JACart/jacart_electronics/PCBFiles/JACart - Rev 3/JACartCommBoard.kicad_pcb

## KiCad design PCBFiles/JACart - Rev 3/JACartCommBoard.kicad_pcb (2022-08-04)

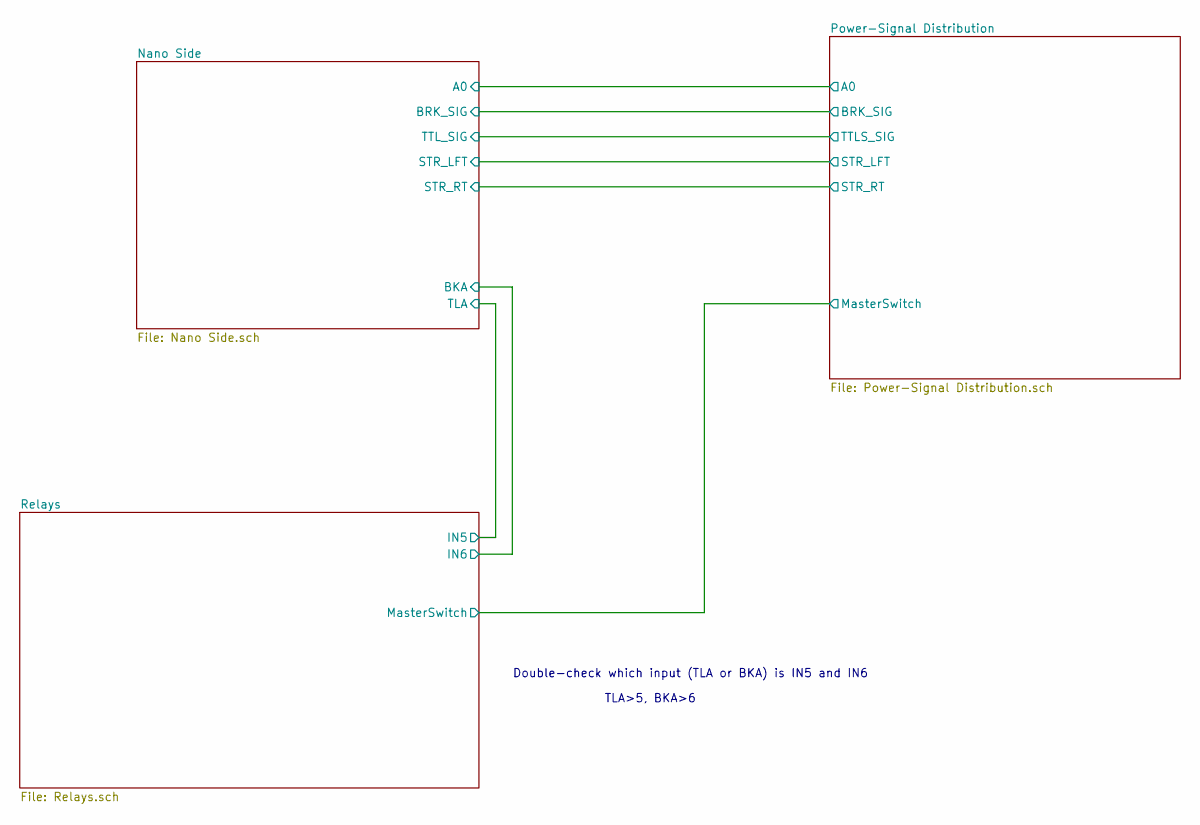
[picture p2: schematic JACartCommBoard.sch]

Notes on the sheet:
Double-check which input (TLA or BKA) is IN5 and IN6
TLA>5, BKA>6

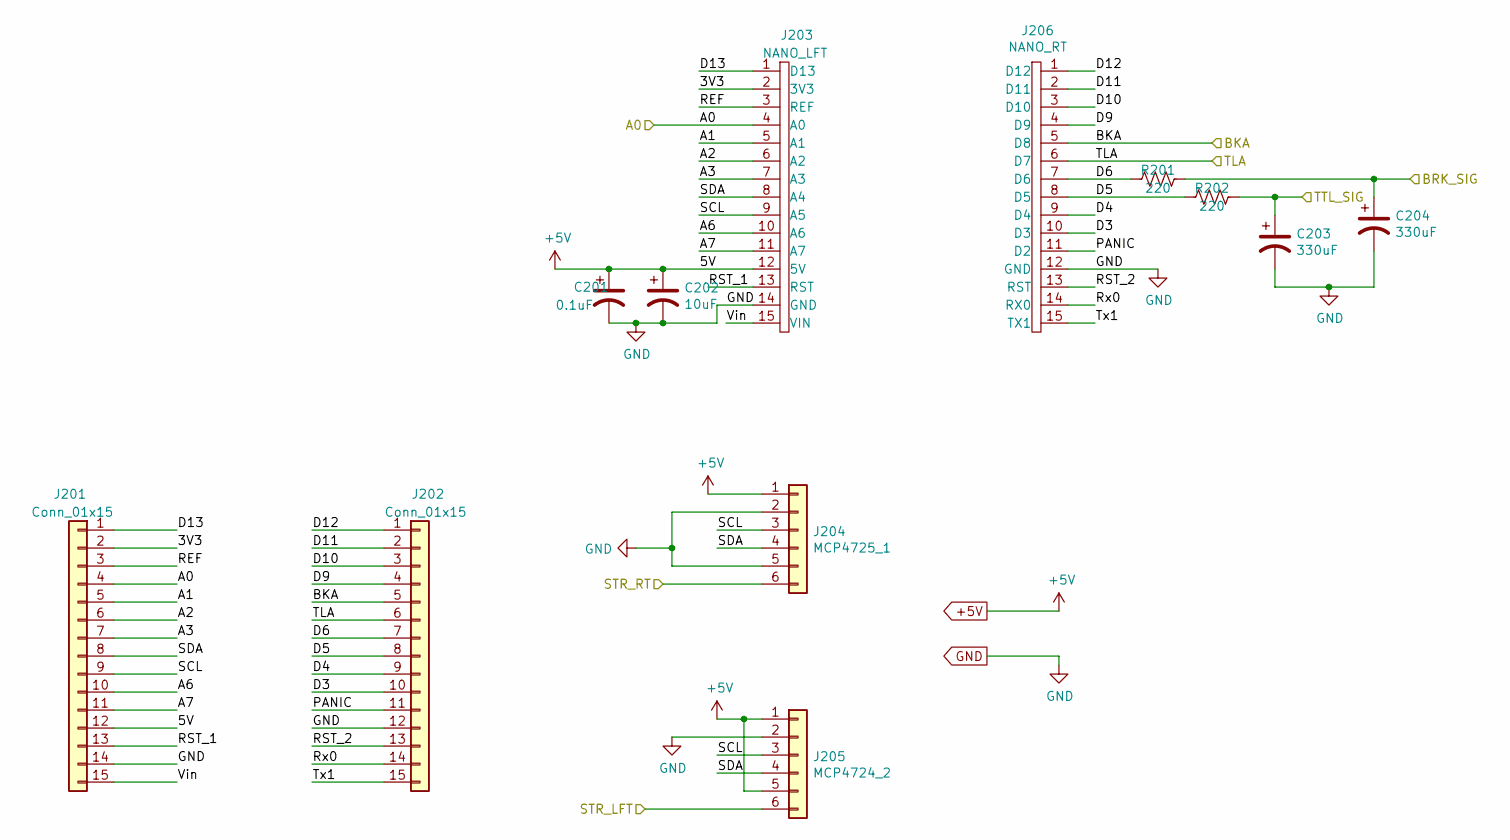
[picture p3: schematic Nano Side.sch]

Parts:
C201: 0.1uF; C_Rect_L7.2mm_W2.5mm_P5.00mm_FKS2_FKP2_MKS2_MKP2
C202: 10uF; CP_Radial_D5.0mm_P2.00mm
C203, C204: 330uF; CP_Radial_D10.0mm_P5.00mm
J201, J202: Conn_01x15; PinHeader_1x15_P2.54mm_Vertical
J203: NANO_LFT; PinSocket_1x15_P2.54mm_Vertical
J204: MCP4725_1; PinSocket_1x06_P2.54mm_Vertical
J205: MCP4724_2; PinSocket_1x06_P2.54mm_Vertical
J206: NANO_RT; PinSocket_1x15_P2.54mm_Vertical
R201, R202: 220; R_1206_3216Metric_Pad1.30x1.75mm_HandSolder

Connections:
+5V: C201.1, C202.1, J201.12 (5V), J203.12 (5V), J204.1, J205.1, J205.5; also elsewhere on the board
/Nano Side/3V3: J201.2 (3V3), J203.2 (3V3)
/Nano Side/A0: J201.4 (A0), J203.4 (A0); also elsewhere on the board
/Nano Side/A1: J201.5 (A1), J203.5 (A1)
/Nano Side/A2: J201.6 (A2), J203.6 (A2)
/Nano Side/A3: J201.7 (A3), J203.7 (A3)
/Nano Side/A6: J201.10 (A6), J203.10 (A6)
/Nano Side/A7: J201.11 (A7), J203.11 (A7)
/Nano Side/BKA: J202.5 (A1), J206.5 (D8); also elsewhere on the board
/Nano Side/D3: J202.10 (A6), J206.10 (D3)
/Nano Side/D4: J202.9 (A5), J206.9 (D4)
/Nano Side/D5: J202.8 (A4), J206.8 (D5), R202.2
/Nano Side/D6: J202.7 (A3), J206.7 (D6), R201.2
/Nano Side/D9: J202.4 (A0), J206.4 (D9)
/Nano Side/D10: J202.3 (REF), J206.3 (D10)
/Nano Side/D11: J202.2 (3V3), J206.2 (D11)
/Nano Side/D12: J202.1 (D13), J206.1 (D12)
/Nano Side/D13: J201.1 (D13), J203.1 (D13)
/Nano Side/PANIC: J202.11 (A7), J206.11 (D2)
/Nano Side/REF: J201.3 (REF), J203.3 (REF)
/Nano Side/RST_1: J201.13 (RST), J203.13 (RST)
/Nano Side/RST_2: J202.13 (RST), J206.13 (RST)
/Nano Side/Rx0: J202.14 (GND), J206.14 (RX0)
/Nano Side/SCL: J201.9 (A5), J203.9 (A5), J204.3, J205.3
/Nano Side/SDA: J201.8 (A4), J203.8 (A4), J204.4, J205.4
/Nano Side/STR_LFT: J205.6; also elsewhere on the board
/Nano Side/STR_RT: J204.6; also elsewhere on the board
/Nano Side/Tx1: J202.15 (VIN), J206.15 (TX1)
/Nano Side/Vin: J201.15 (VIN), J203.15 (VIN)
/Relays/IN5: J202.6 (A2), J206.6 (D7); also elsewhere on the board
GND: C201.2, C202.2, C203.2, C204.2, J201.14 (GND), J202.12 (5V), J203.14 (GND), J204.2, J204.5, J205.2, J206.12 (GND); also elsewhere on the board
NO1: C204.1, R201.1; also elsewhere on the board
NO3: C203.1, R202.1; also elsewhere on the board

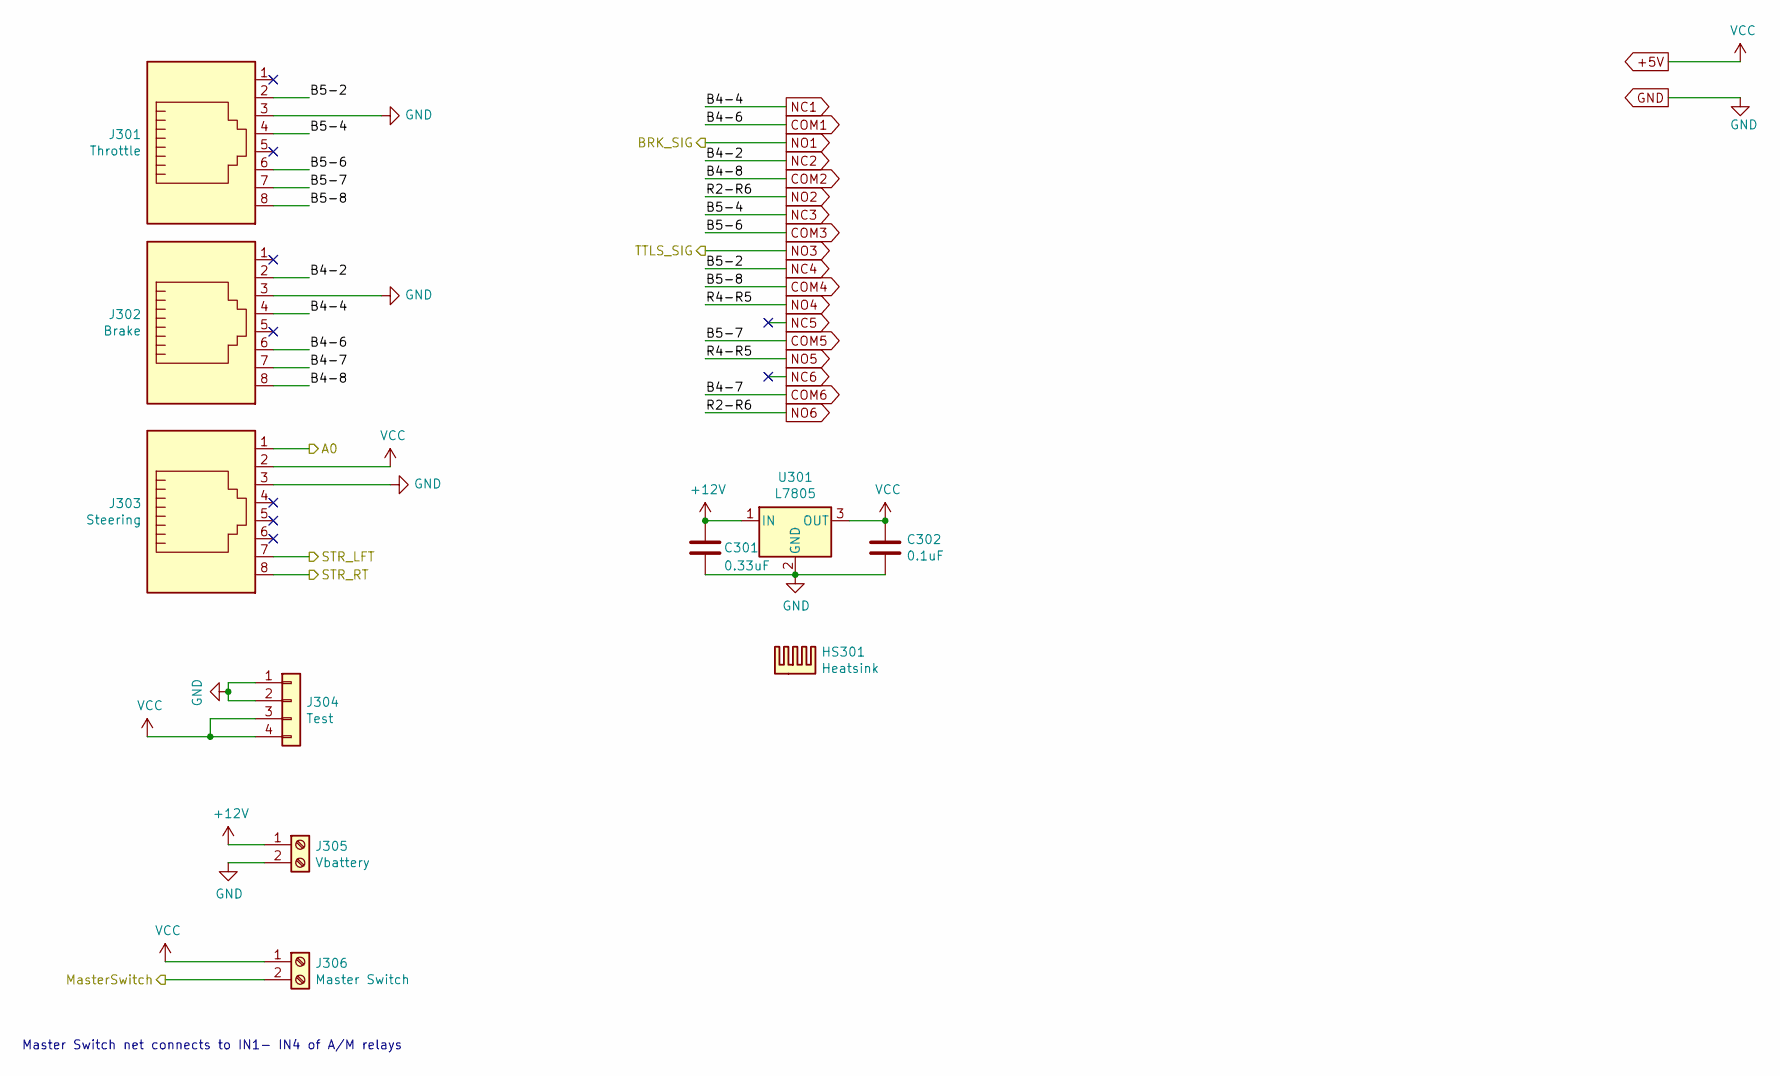
[picture p4: schematic Power-Signal Distribution.sch]

Parts:
C301: 0.33uF; C_1206_3216Metric_Pad1.33x1.80mm_HandSolder
C302: 0.1uF; C_1206_3216Metric_Pad1.33x1.80mm_HandSolder
HS301: Heatsink; HSINK_6398BG
J301: Throttle; TE_1-406525-1
J302: Brake; TE_1-406525-1
J303: Steering; TE_1-406525-1
J304: Test; PinHeader_1x04_P2.54mm_Vertical
J305: Vbattery; TE_282837-2
J306: Master Switch; TE_282837-2
U301: L7805; TO-220-3_Vertical

Connections:
+5V: C302.1, J303.2, J304.3, J304.4, J306.1, U301.3 (OUT); also elsewhere on the board
+12V: C301.1, J305.1, U301.1 (IN)
/Nano Side/A0: J303.1; also elsewhere on the board
/Nano Side/STR_LFT: J303.7; also elsewhere on the board
/Nano Side/STR_RT: J303.8; also elsewhere on the board
/Power-Signal Distribution/MasterSwitch: J306.2; also elsewhere on the board
COM1: J302.6; also elsewhere on the board
COM2: J302.8; also elsewhere on the board
COM3: J301.6; also elsewhere on the board
COM4: J301.8; also elsewhere on the board
COM5: J301.7; also elsewhere on the board
COM6: J302.7; also elsewhere on the board
GND: C301.2, C302.2, J301.3, J302.3, J303.3, J304.1, J304.2, J305.2, U301.2 (GND); also elsewhere on the board
NC1: J302.4; also elsewhere on the board
NC2: J302.2; also elsewhere on the board
NC3: J301.4; also elsewhere on the board
NC4: J301.2; also elsewhere on the board

Notes on the sheet:
Master Switch net connects to IN1- IN4 of A/M relays

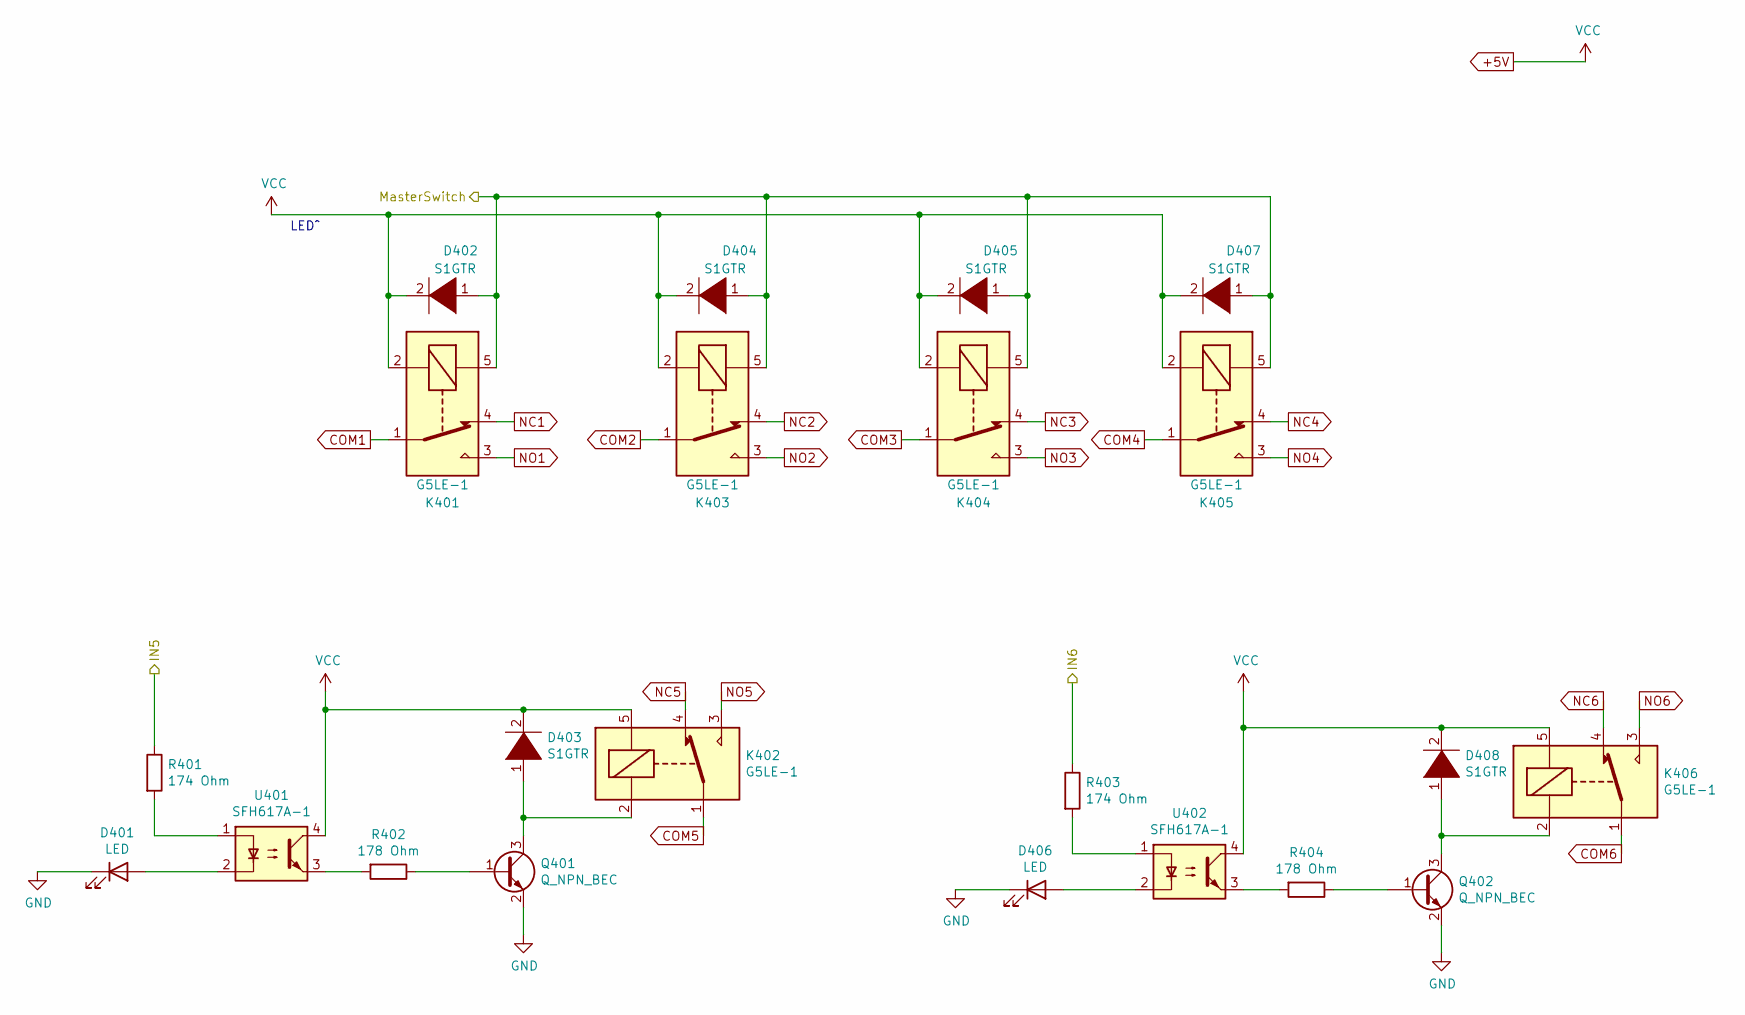
[picture p5: schematic Relays.sch]

Parts:
D401, D406: LED; D_1206_3216Metric_Pad1.42x1.75mm_HandSolder
D402, D403, D404, D405, D407, D408: S1GTR
K401, K402, K403, K404, K405, K406: G5LE-1; Relay_SPDT_Omron-G5LE-1
Q401, Q402: Q_NPN_BEC; TO-126-3_Vertical
R401, R403: 174 Ohm; R_1206_3216Metric_Pad1.30x1.75mm_HandSolder
R402, R404: 178 Ohm; R_1206_3216Metric_Pad1.30x1.75mm_HandSolder
U401, U402: SFH617A-1; DIP-4_W7.62mm

Connections:
+5V: D402.2 (A), D403.2 (A), D404.2 (A), D405.2 (A), D407.2 (A), D408.2 (A), K401.2, K402.5, K403.2, K404.2, K405.2, K406.5, U401.4, U402.4; also elsewhere on the board
/Nano Side/BKA: R403.1; also elsewhere on the board
/Power-Signal Distribution/MasterSwitch: D402.1 (K), D404.1 (K), D405.1 (K), D407.1 (K), K401.5, K403.5, K404.5, K405.5; also elsewhere on the board
/Relays/IN5: R401.1; also elsewhere on the board
COM1: K401.1; also elsewhere on the board
COM2: K403.1; also elsewhere on the board
COM3: K404.1; also elsewhere on the board
COM4: K405.1; also elsewhere on the board
COM5: K402.1; also elsewhere on the board
COM6: K406.1; also elsewhere on the board
GND: D401.1 (K), D406.1 (K), Q401.2 (E), Q402.2 (E); also elsewhere on the board
NC1: K401.4; also elsewhere on the board
NC2: K403.4; also elsewhere on the board
NC3: K404.4; also elsewhere on the board
NC4: K405.4; also elsewhere on the board
NC5: K402.4
NC6: K406.4
NO1: K401.3; also elsewhere on the board
NO3: K404.3; also elsewhere on the board
unnamed: D401.2 (A), U401.2
unnamed: D403.1 (K), K402.2, Q401.3 (C)
unnamed: D406.2 (A), U402.2
unnamed: D408.1 (K), K406.2, Q402.3 (C)
unnamed: Q401.1 (B), R402.1
unnamed: Q402.1 (B), R404.1
unnamed: R401.2, U401.1
unnamed: R402.2, U401.3
unnamed: R403.2, U402.1
unnamed: R404.2, U402.3

Notes on the sheet:
LED^

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
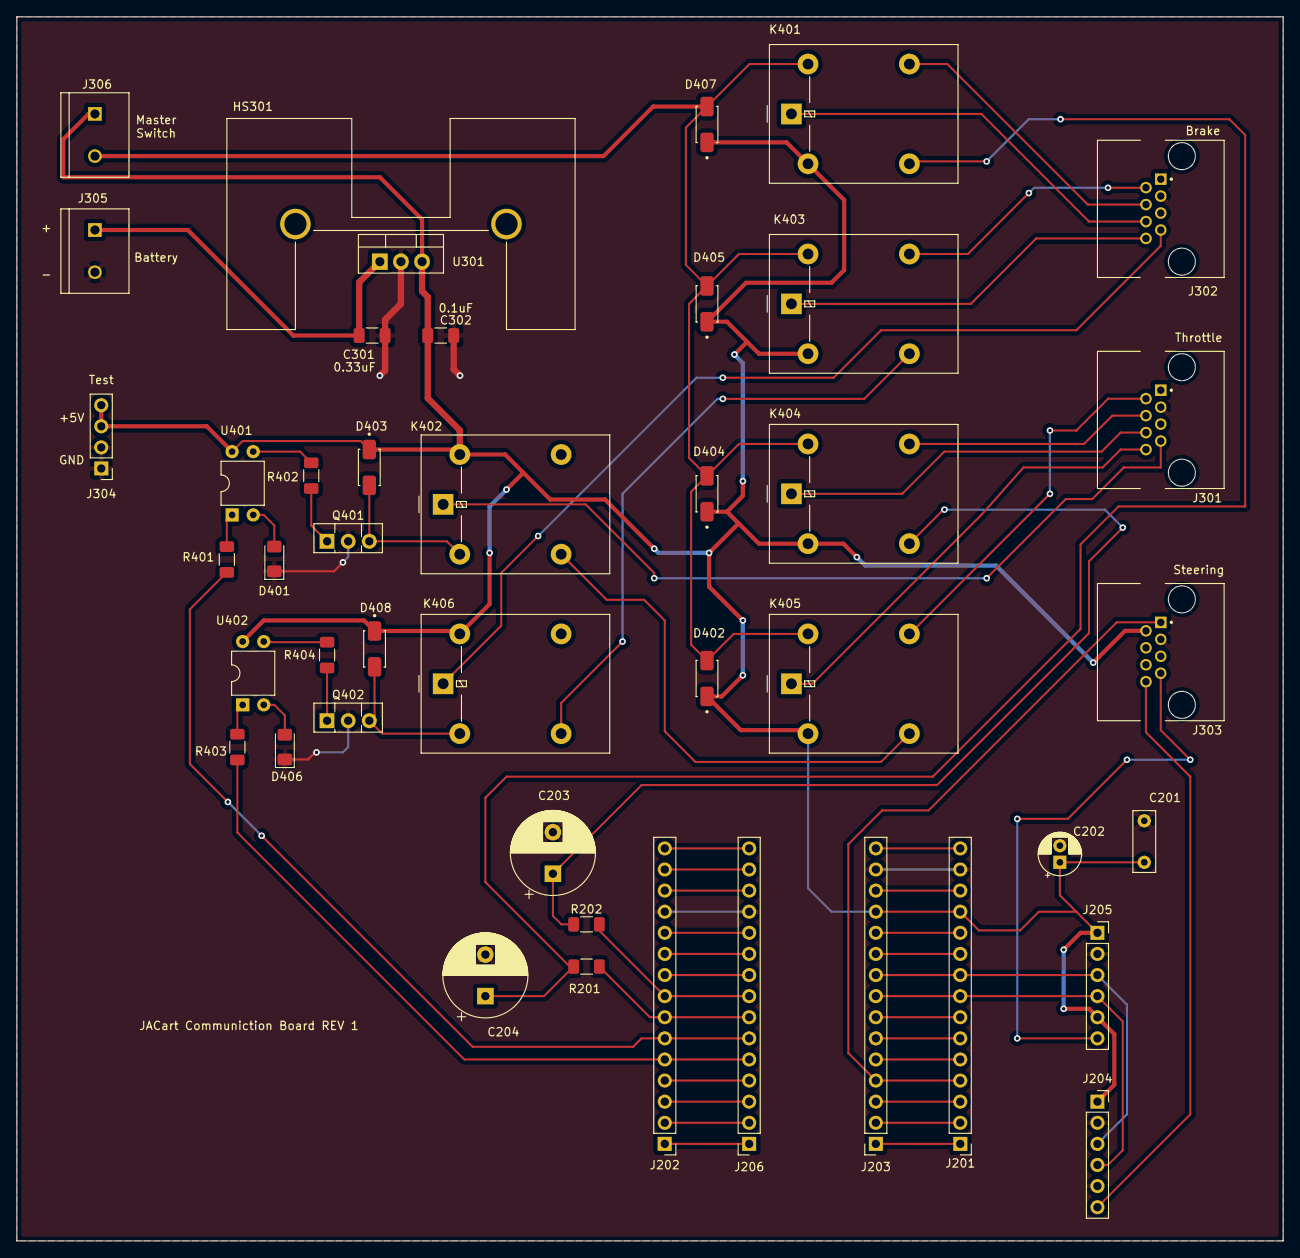
[picture p6: board JACartCommBoard.kicad_pcb from above]

Board: 2 copper layers, 152.4 x 147.3 mm, 44 parts (0 on the bottom side), 57 nets.
