JACart/jacart_electronics/(commit log)

2022-06-17 Added code for Xbee remote kill switch
2022-07-11 Add functions for relay
2022-07-14 Add verbose print outs for debugging
2022-07-14 Correct LED operation
2022-07-14 Remove annoying printout (again)
2022-08-04 Re-organize PCB files
    [JACart.brd, JACart.kicad_pcb, JACart.sch, JACart2.brd, JACart2.sch, JACartCommBoard.kicad_pcb, JACartCommBoard.sch, Motherboard_1.brd]
